compukidmike/DC26/README.md

# DEFCON 26 Projects
This is all the source code and production files for the badges we made for Defcon 26
