compukidmike/DC26/Trevor Totem/Readme.md

# Trevor Totem
The Trevor Totem was a last minute project for Defcon. It holds 7 SAOs and provides power via 2 AA batteries. It also has LEDs to light up the eyes.

If you're unfamiliar with Trevor the Roach, I suggest watching this video: https://www.youtube.com/watch?v=oOXcol_fFGQ

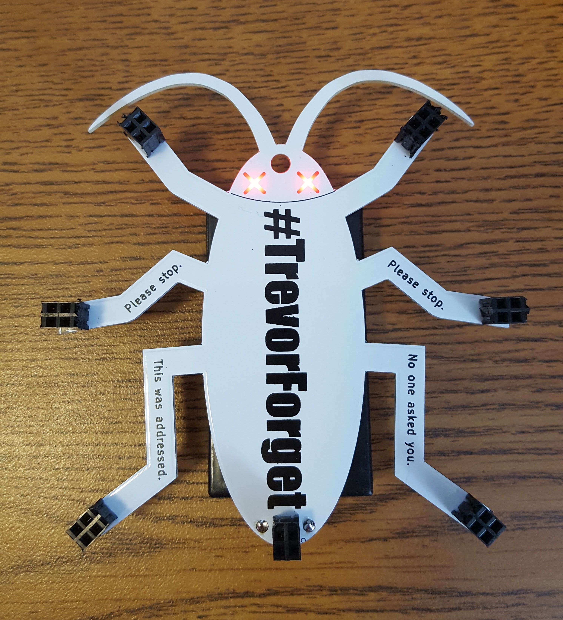
[picture p1: Trevor Totem/TrevorTotem.jpg]
