compukidmike/DC26/GoonBoxBadge/GoonBoxBadge BOM.pdf

Goon Box Badge BOM

Goon Box Pin Part | Qty Reference | Part Number | Vendor Part Number | Link | Alt Link
IR Receiver | 1 U1 | TSOP33438 | TSOP33438-ND | https://www.digikey.com/product-detail/en/vishay-semiconductor-opto-division/TSOP33438/TSOP33438-ND/6210651 https://www.mouser.com/ProductDetail/Vishay-Semiconductors/TSOP33438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 Resistor 0805 240 | 1 R1 | RC0805JR-07240RL | 311-240ARCT-ND | https://www.digikey.com/product-detail/en/yageo/RC0805JR-07240RL/311-240ARCT-ND/731234 Red LED | 1 D1 | 151051RS11000 | 732-5016-ND | https://www.digikey.com/product-detail/en/wurth-electronics-inc/151051RS11000/732-5016-ND/4490012 Battery Holder | 1 BT1 | BAT-HLD-001 | BAT-HLD-001-ND | https://www.digikey.com/product-detail/en/linx-technologies-inc/BAT-HLD-001/BAT-HLD-001-ND/1577235 https://www.mouser.com/ProductDetail/712-BAT-HLD-001 Tie Tack | 1 N/A | N/A | N/A | https://www.amazon.com/Mudder-Butterfly-Clutch-Replacement-Making/dp/B06VXNN1HK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 https://www.amazon.com/Butterfly-Clutch-Replacement-Length-Making/dp/B072B9XGZ4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
PCB 35x50mm | 1 | www.allpcb.com
Screwdriver Part | Qty | Link | Alt Link
IR LED | 1 D1 | SFH 4045N | 475-3047-1-ND | https://www.digikey.com/product-detail/en/osram-opto-semiconductors-inc/SFH-4045N/475-3047-1-ND/4360717
LEDs (red) | 8 D2,D3,D4,D5,D6,D7,D8,D9 | LS T776-P2S1-1-Z | 720-LST776-P2S1-1-Z | https://www.digikey.com/product-detail/en/osram-opto-semiconductors-inc/LS-T776-P2S1-1-Z/475-2517-1-ND/1802644 https://www.mouser.com/ProductDetail/OSRAM-Opto-Semiconductors/LS-T776-P2S1-1-Z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 Resonator 8MHz | 1 Y1 | AWSCR-8.00CV-T | 535-10004-1-ND | https://www.digikey.com/product-detail/en/abracon-llc/AWSCR-8.00CV-T/535-10004-1-ND/2001627 Battery Holder | 1 BT1 | BC12AAPC | BC12AAPC-ND | https://www.digikey.com/product-detail/en/mpd-memory-protection-devices/BC12AAPC/BC12AAPC-ND/2439230
attiny84a | 1 U1 | ATTINY84A-SSUR | ATTINY84A-SSURCT-ND | https://www.digikey.com/product-detail/en/microchip-technology/ATTINY84A-SSUR/ATTINY84A-SSURCT-ND/2774136 Buzzer | 1 BZ1 | PKM13EPYH4000-A0 | 490-4698-ND | https://www.digikey.com/product-detail/en/murata-electronics-north-america/PKM13EPYH4000-A0/490-4698-ND/1219329 Transistor NPN | 1 Q1 | MMBT2222ALT1HTSA1 MMBT2222ALT1HTSA1CT-ND https://www.digikey.com/product-detail/en/on-semiconductor/MMBT2222ALT3G/MMBT2222ALT3GOSCT-ND/1967145 Capacitor 0603 0.1uF | 1 C1 | CL10B104MO8NNNC | 1276-1031-1-ND | https://www.digikey.com/scripts/DkSearch/dksus.dll?Detail&itemSeq=258767980&uq=636600916293556276 Resistor LEDs/Transistor 0603 100 | 9 R6,R8,R9,R10,R11,R12,R13,R14,R15 RMCF0603FG100R | RMCF0603FG100RCT-ND | https://www.digikey.com/product-detail/en/yageo/RC0603JR-07100RL/311-100GRCT-ND/729644 On/Off Switch | 1 SW1 | JS202011JCQN | CKN10723CT-ND | https://www.digikey.com/product-detail/en/c-k/JS202011JCQN/CKN10723CT-ND/6137637 Resistor IR LED 0603 10 | 2 R1,R7 | RMCF0603FG100R | RMCF0603FG100RCT-ND | https://www.digikey.com/product-detail/en/yageo/RC0603JR-07100RL/311-100GRCT-ND/729644 Resistor Touch Buttons 0603 10k | 4 R2,R3,R4,R5 | RC0603JR-0710KL | 311-10KGRCT-ND | https://www.digikey.com/scripts/DkSearch/dksus.dll?Detail&itemSeq=258767456&uq=636600928661943953 PCB 25x150mm | 1 | www.allpcb.com
