compukidmike/DC26/Llama SAO/Llama SAO BOM.xlsx

Llama SAO BOM
Part | Qty | Reference | Part Number | Vendor Part Number | Link | Alt Link
4 pin Header Male | 1 | X1 | 67997-404HLF | 609-3242-ND | https://www.digikey.com/product-detail/en/amphenol-fci/67997-404HLF/609-3242-ND/1878458
Resistor LEDs/Transistor 0603 100 | 1 | R1 | RMCF0603FG100R | RMCF0603FG100RCT-ND | https://www.digikey.com/product-detail/en/yageo/RC0603JR-07100RL/311-100GRCT-ND/729644
LEDs (red) | 2 | D1, D2 | LS T776-P2S1-1-Z | 720-LST776-P2S1-1-Z | https://www.digikey.com/product-detail/en/osram-opto-semiconductors-inc/LS-T776-P2S1-1-Z/475-2517-1-ND/1802644
PCB 90x94mm | 1 |  |  |  | www.allpcb.com
