compukidmike/DC26/Trevor Totem/Trevor Totem BOM.xlsx

Trevor Totem BOM
Part | Qty | Reference | Part Number | Vendor Part Number | Link | Alt Link
4 pin Header Female | 1 | X1, X2, X3, X4, X5, X6, X7 | PPTC022LFBN-RC | S7070-ND | https://www.digikey.com/product-detail/en/sullins-connector-solutions/PPTC022LFBN-RC/S7070-ND/810209
Resistor LEDs/Transistor 0603 100 | 1 | R1 | RMCF0603FG100R | RMCF0603FG100RCT-ND | https://www.digikey.com/product-detail/en/yageo/RC0603JR-07100RL/311-100GRCT-ND/729644
LEDs (red) | 2 | D1, D2 | LS T776-P2S1-1-Z | 720-LST776-P2S1-1-Z | https://www.digikey.com/product-detail/en/osram-opto-semiconductors-inc/LS-T776-P2S1-1-Z/475-2517-1-ND/1802644
Battery Holder | 1 | BT1 | 2463 | 36-2463-ND | https://www.digikey.com/product-detail/en/keystone-electronics/2463/36-2463-ND/303812
PCB 90x94mm | 1 |  |  |  | www.allpcb.com
