compukidmike/DC26/Trevor Totem/KiCad Files/TrevorTotem.kicad_pcb

## KiCad design Trevor Totem/KiCad Files/TrevorTotem.kicad_pcb (2018-08-13)

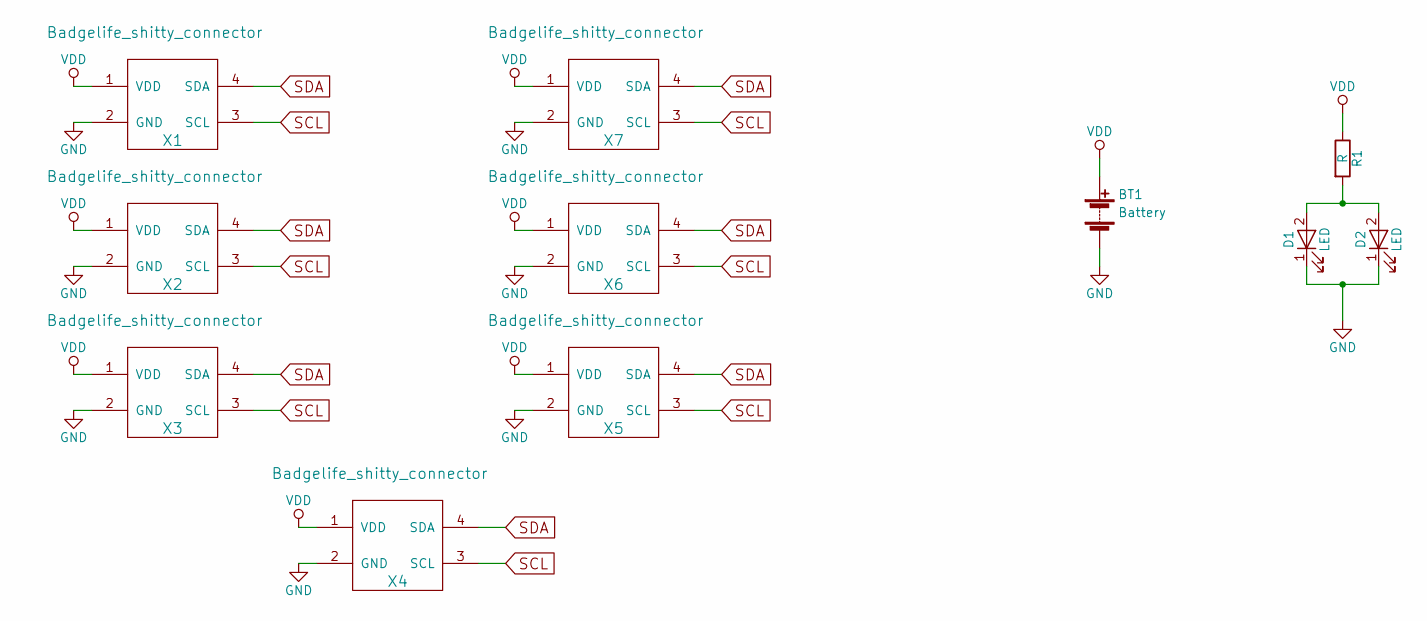
[picture p5: schematic TrevorTotem.sch]

Parts:
BT1: Battery; Battery-WireConn
D1, D2: LED; LED-SMD-BottomEntry-OSRAM-LS-T776
R1: R; R_0603_HandSoldering
X1, X2, X3, X4, X5, X6, X7: Badgelife_shitty_connector; Badgelife-Shitty-2x2

Connections:
GND: BT1.2 (-), D1.1 (K), D2.1 (K), X1.2 (GND), X2.2 (GND), X3.2 (GND), X4.2 (GND), X5.2 (GND), X6.2 (GND), X7.2 (GND)
unnamed: D1.2 (A), D2.2 (A), R1.2
SCL: X1.3 (SCL), X2.3 (SCL), X3.3 (SCL), X4.3 (SCL), X5.3 (SCL), X6.3 (SCL), X7.3 (SCL)
SDA: X1.4 (SDA), X2.4 (SDA), X3.4 (SDA), X4.4 (SDA), X5.4 (SDA), X6.4 (SDA), X7.4 (SDA)
VDD: BT1.1 (+), R1.1, X1.1 (VDD), X2.1 (VDD), X3.1 (VDD), X4.1 (VDD), X5.1 (VDD), X6.1 (VDD), X7.1 (VDD)

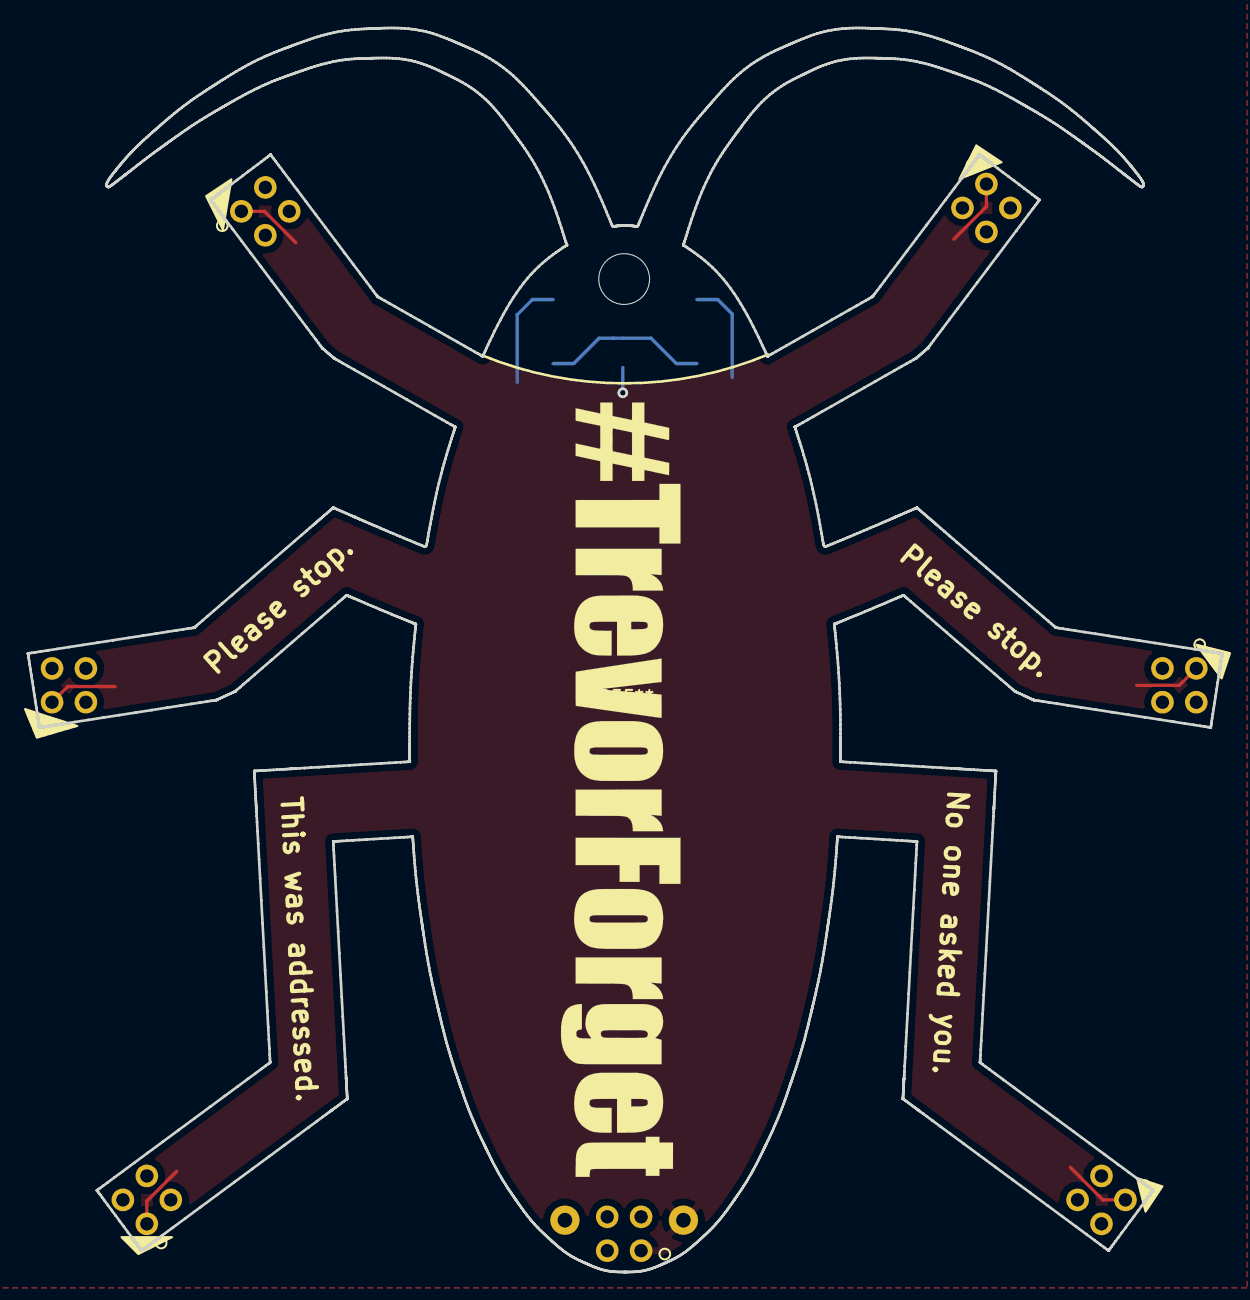
[picture p6: board TrevorTotem.kicad_pcb from above]

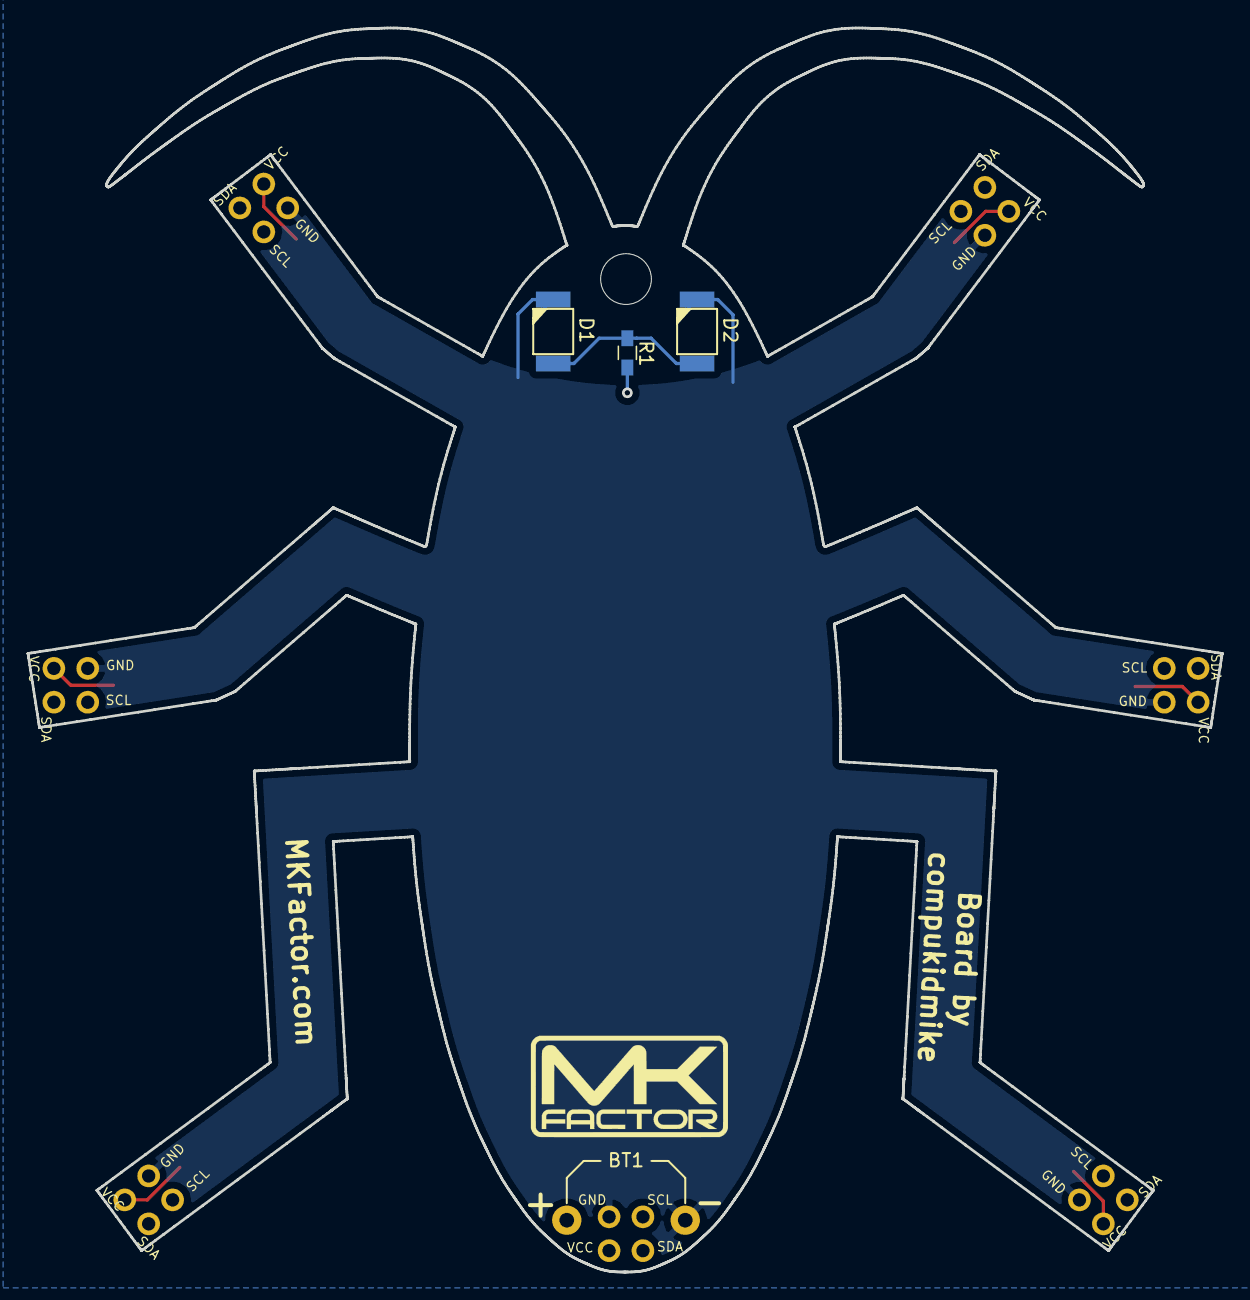
[picture p7: board TrevorTotem.kicad_pcb from below]

Board: 2 copper layers, 89.6 x 93.3 mm, 11 parts (4 on the bottom side), 5 nets.
