compukidmike/DC26/GoonBoxBadge/KiCad Files/Screwdriver/ScrewdriverBadge.kicad_pcb

## KiCad design GoonBoxBadge/KiCad Files/Screwdriver/ScrewdriverBadge.kicad_pcb (2018-08-13)

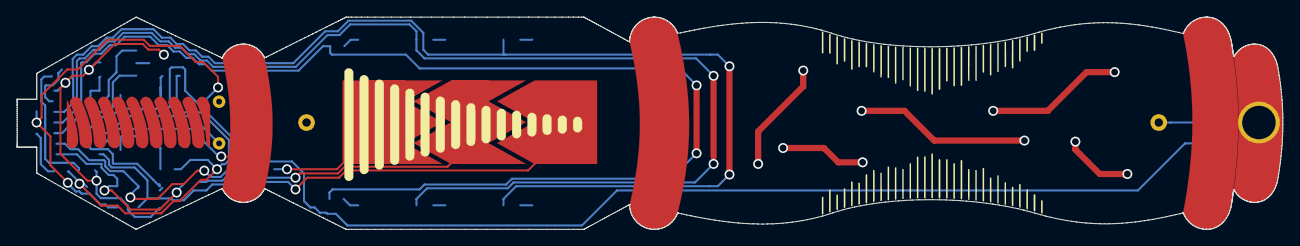
[picture p8: board ScrewdriverBadge.kicad_pcb from above]

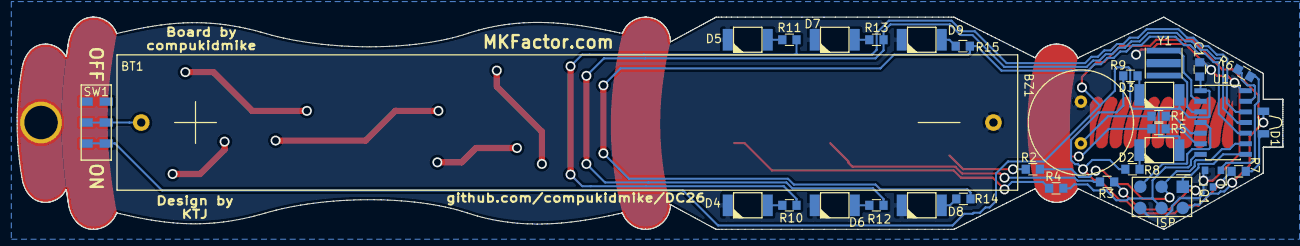
[picture p9: board ScrewdriverBadge.kicad_pcb from below]

Board: 2 copper layers, 151.5 x 25.4 mm, 36 parts (32 on the bottom side), 31 nets.

Parts:
BT1: Battery; Battery-2AA-BC12AAPC
BZ1: Buzzer; Buzzer-12.6mm-Murata-PKM13EPYH4000
C1: 0.1uF; R_0603_Mid
D1: LED; LED-IR-RA-OSRAM-SFH-4045N
D2, D3, D4, D5, D6, D7, D8, D9: LED; LED-SMD-BottomEntry-OSRAM-LS-T776
ISP: AVR-ISP-6; ISP-AVR-6Pin-SMD
Q1: BC817; SOT-23
R1, R2, R3, R4, R5, R6, R7, R8, R9, R10, R11, R12, R13, R14, R15: R; R_0603_Mid
SW1: SW_SPST; JS202011JCQN
TP1: SLIDER1; TestPad-SMD-1mm-Tented
TP2: SLIDER2; TestPad-SMD-1mm-Tented
TP3: SLIDER3; TestPad-SMD-1mm-Tented
TP4: FUNC; TestPad-SMD-1mm-Tented
U1: ATTINY84A-SSU; SOIC-14_3.9x8.7mm_Pitch1.27mm
Y1: Resonator; Resonator-AWSCR-3.7x3.1mm

Connections:
+BATT: C1.1, D1.2, D2.2, D3.2, ISP.2, SW1.1, U1.1
BUZZ: R1.2, U1.5
GND: BT1.2, BZ1.2, C1.2, D4.1, D5.1, D6.1, D7.1, D8.1, D9.1, ISP.6, Q1.2, U1.14, Y1.2
IRLED: R6.2, U1.13
LED1: R10.2, R11.2, U1.12
LED2: R12.2, R13.2, U1.11
LED3: R14.2, R15.2, U1.10
MISO: ISP.1, R3.2, U1.8
MOSI: ISP.4, R4.2, U1.7
unnamed: BT1.1, SW1.2
unnamed: BZ1.1, R1.1
unnamed: D1.1, R7.2
unnamed: D2.1, R8.2
unnamed: D3.1, R9.2
unnamed: D4.2, R10.1
unnamed: D5.2, R11.1
unnamed: D6.2, R12.1
unnamed: D7.2, R13.1
unnamed: D8.2, R14.1
unnamed: D9.2, R15.1
unnamed: Q1.1, R6.1
unnamed: Q1.3, R7.1, R8.1, R9.1
unnamed: R2.1, TP1.1
unnamed: R3.1, TP2.1
unnamed: R4.1, TP3.1
unnamed: R5.1, TP4.1
unnamed: R5.2, U1.6
unnamed: U1.2, Y1.3
unnamed: U1.3, Y1.1
RST: ISP.5, U1.4
SCK: ISP.3, R2.2, U1.9
