compukidmike/DC26/GoonBoxBadge/KiCad Files/GoonBoxPin/GoonBox.kicad_pcb

## KiCad design GoonBoxBadge/KiCad Files/GoonBoxPin/GoonBox.kicad_pcb (2018-08-13)

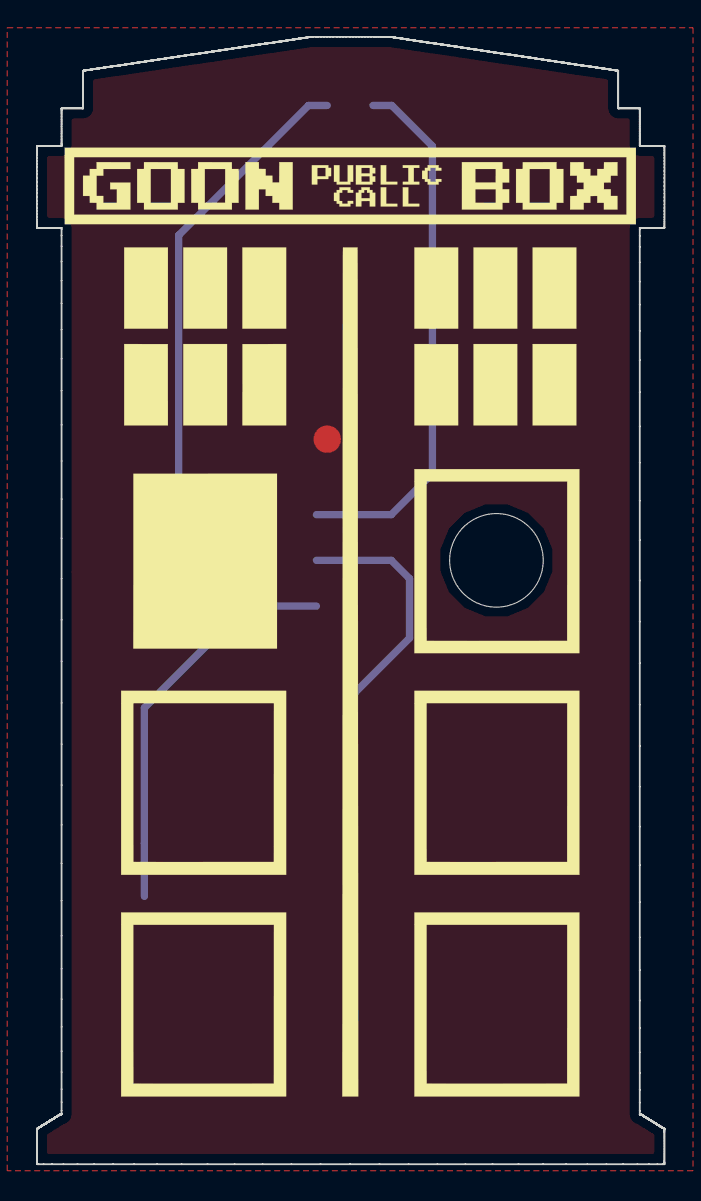
[picture p10: board GoonBox.kicad_pcb from above]

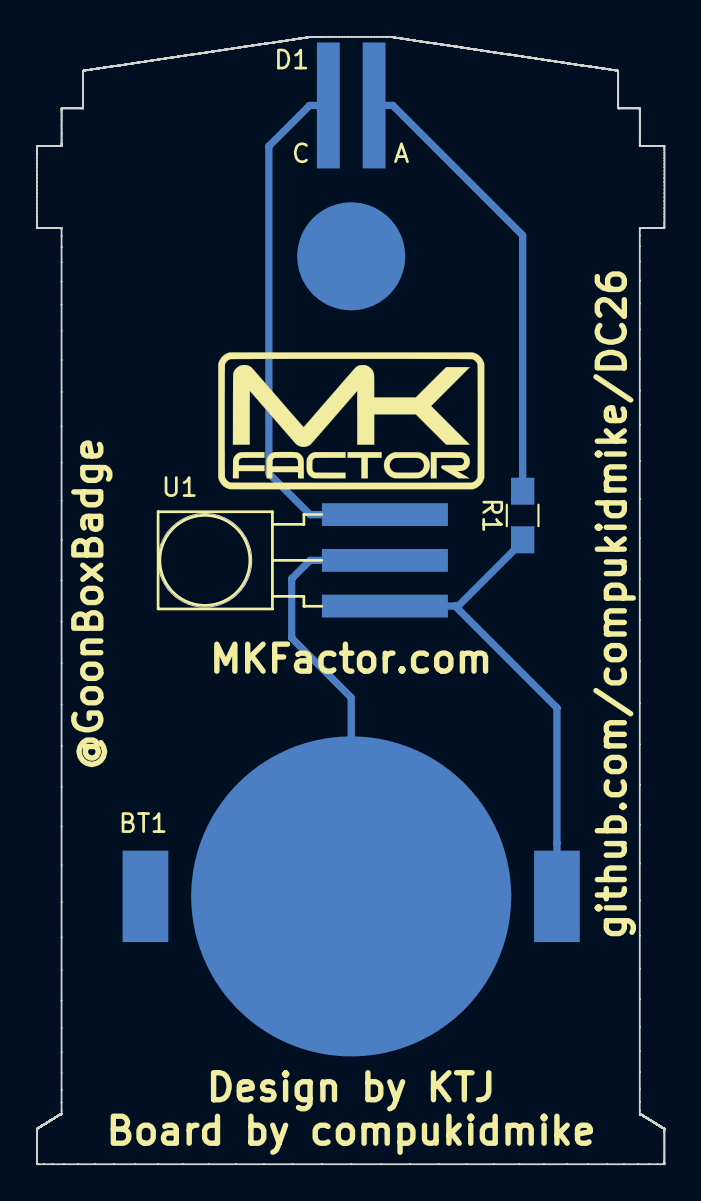
[picture p11: board GoonBox.kicad_pcb from below]

Board: 2 copper layers, 34.9 x 62.6 mm, 4 parts (4 on the bottom side), 4 nets.

Parts:
BT1: Battery_Cell; Linx-BAT-HLD-001
D1: LED; LED-5MM-SMT-FLAT
R1: R; R_0805_HandSoldering
U1: TSOP331xx; TSOP332-IR-RCV

Connections:
+BATT: BT1.1, R1.1, U1.3
GND: BT1.2, U1.2
unnamed: D1.1, U1.1
unnamed: D1.2, R1.2
