compukidmike/DC26/Llama SAO/KiCad Files/LlamaSAO.sch

## KiCad design Llama SAO/KiCad Files/LlamaSAO.sch (2018-08-13)

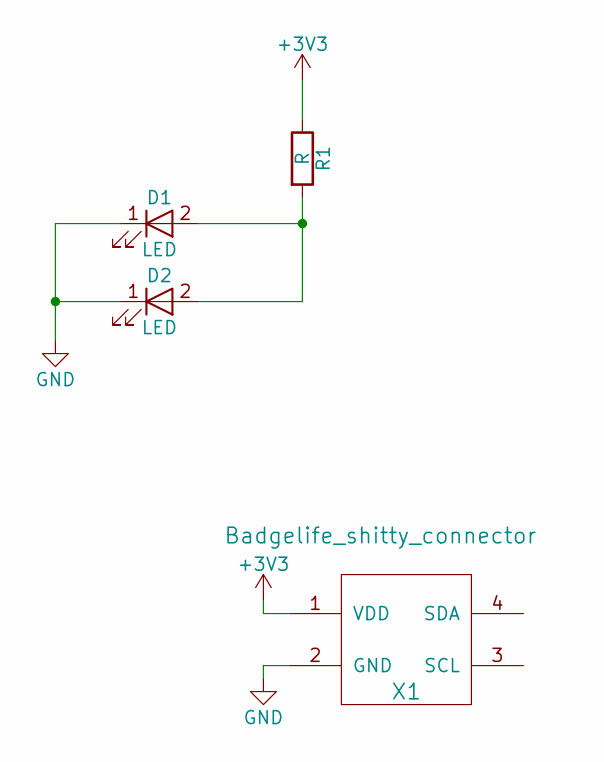
[picture p12: schematic LlamaSAO.sch]

Parts:
D1, D2: LED; LED-SMD-BottomEntry-OSRAM-LS-T776
R1: R; R_0603_Mid
X1: Badgelife_shitty_connector; Badgelife-Shitty-2x2

Connections:
+3V3: R1.1, X1.1 (VDD)
GND: D1.1 (K), D2.1 (K), X1.2 (GND)
unnamed: D1.2 (A), D2.2 (A), R1.2
