compukidmike/DC26/GoonBoxBadge/Code/Screwdriver Badge/screwdriver.h

/**********************************************************************
* Written by WAVToCode
* Date:				Sun Mar 18 05:49:25 PM
* FileName:			screwdriver3.C
* Interleaved:		Yes
* Signed:			No
* No. of channels:	1
* No. of samples:	2721
* Bits/Sample:		8
**********************************************************************/

#define NUM_ELEMENTS 2329

const unsigned char screwdriverSound[NUM_ELEMENTS] PROGMEM = {32, 242, 67, 102, 211, 46, 156, 163, 54, 197, 94, 112, 183, 56, 183, 112, 97, 187, 69, 158, 136, 87, 177, 95, 126, 164, 77, 162, 129, 95, 164, 115, 104, 174, 84, 146, 138, 101, 148, 129, 103, 161, 104, 131, 142, 107, 144, 122, 122, 143, 108, 145, 118, 127, 135, 119, 134, 125, 126, 130, 129, 115, 148, 108, 137, 129, 123, 125, 140, 110, 144, 111, 145, 110, 142, 118, 135, 119, 136, 124, 123, 137, 118, 132, 129, 123, 132, 126, 126, 135, 114, 145, 110, 137, 133, 102, 169, 83, 157, 125, 100, 171, 92, 131, 167, 56, 200, 91, 106, 199, 43, 175, 151, 42, 221, 93, 72, 244, 26, 148, 195, 24, 196, 132, 62, 209, 74, 130, 174, 53, 199, 89, 116, 181, 59, 179, 115, 99, 181, 76, 151, 145, 80, 176, 108, 105, 174, 91, 125, 170, 72, 159, 140, 80, 176, 109, 107, 169, 93, 139, 139, 104, 150, 114, 127, 142, 104, 152, 111, 132, 132, 118, 137, 123, 125, 135, 122, 124, 140, 112, 139, 121, 134, 116, 143, 110, 143, 113, 143, 112, 142, 115, 137, 123, 127, 133, 119, 138, 115, 139, 121, 124, 139, 114, 134, 135, 107, 154, 106, 133, 145, 89, 177, 83, 153, 129, 97, 175, 86, 137, 165, 51, 211, 75, 121, 192, 34, 201, 119, 59, 234, 54, 113, 225, 11, 184, 165, 31, 213, 106, 79, 210, 60, 148, 162, 55, 207, 75, 131, 173, 56, 191, 101, 107, 184, 65, 165, 134, 80, 189, 88, 122, 176, 69, 154, 153, 66, 182, 119, 84, 192, 82, 132, 156, 92, 148, 131, 104, 160, 99, 142, 130, 111, 149, 110, 137, 127, 120, 137, 123, 124, 137, 119, 131, 130, 122, 136, 116, 143, 112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
120, 125, 140, 110, 142, 121, 124, 144, // 280-287
100, 161, 103, 135, 142,  98, 165,  97, // 288-295
140, 139,  95, 164, 106, 122, 156,  92, // 296-303
149, 129, 103, 162, 101, 131, 152,  91, // 304-311
150, 136, 100, 147, 125, 110, 147, 125, // 312-319
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
*/
