compukidmike/DC26/GoonBoxBadge/Code/Screwdriver Badge/NAcodes.c

#include <avr/io.h>             // this contains all the IO port definitions
#include <avr/pgmspace.h>       // definitions or keeping constants in program memory
#include "main.h"

// table of POWER codes
// These codes have been heavily modified to work with the Goon Box Badge Screwdriver!
// You can find the original here: https://learn.adafruit.com/tv-b-gone-kit/

#define freq_to_timerval(x) ((F_CPU / x - 1 )/ 2)

  
// Code 000 -- Sony, Baur, Neckermann, Otto Versand, Palladium, Quelle, SEI, Sinudyne, Sonolor, Universum
const struct powercode sonyCode PROGMEM = {
  //freq_to_timerval(37470), // 37.47 KHz  
  104,
  {{184, 45},
   {92 , 45},
   {46 , 45},
   {92, 45},
   {46 , 45},
   {92, 45},
   {46 , 45},
   {46 , 45},
   {92, 45},
   {46 , 45},
   {46 , 45},
   {46 , 45},
   {46 , 2068},
   {184, 45},
   {92, 45},
   {46 , 45},
   {92, 45},
   {46 , 45},
   {92, 45},
   {46 , 45},
   {46 , 45},
   {92, 45},
   {46 , 45},
   {46 , 45},
   {46 , 45},
   {46 , 0}// end of code
  }
};

//Code 001 - Proscan, RCA, Curtis Mathes, Dimensia, GE, JC Penney, LXI, Radio Shack/Realistic, Sears, Wards
const struct powercode rcaCode PROGMEM = {
  //freq_to_timerval(55600), // 55.6 KHz  
  70,
  {{ 457,   456 },
   {  58,   228 },
   {  58,   228 },
   {  58,   228 },
   {  58,   228 },
   {  58,   113 },
   {  58,   113 },
   {  58,   228 },
   {  58,   113 },
   {  58,   228 },
   {  58,   113 },
   {  58,   228 },
   {  58,   113 },
   {  58,   113 },
   {  58,   113 },
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
    { 59,	   57},
    { 59,	   57},
    { 59,	   57},
    { 58,	  178},
    { 59,	  178},
    { 59,	  178},
    { 59,	   57},
    { 59,	   57},
    { 59,	  178},
    { 59,	  178},
    { 59,	  178},
    { 59,	 4260},
    {924,	  231},
    { 59,	 9752},
    {924,	  231},
    { 59,	    0}
  }
};

// Code 054 - JVC
const struct powercode jvc3Code PROGMEM = {
  freq_to_timerval(38970),
  { {924,	  459},
    { 59,	  178},
    { 59,	  178},
    { 59,	  178},
    { 59,	   57},
    { 59,	  178},
    { 59,	  178},
    { 59,	   57},
    { 59,	   57},
    { 59,	   57},
    { 59,	   57},
    { 59,	   57},
    { 59,	  178},
    { 59,	   57},
    { 59,	   57},
    { 59,	  178},
    { 59,	  178},
    { 59,	   57},
    { 59,	  178},
    { 59,	   57},
    { 59,	   57},
    { 59,	  178},
    { 59,	   57},
    { 59,	   57},
    { 59,	   57},
    { 59,	  178},
    { 59,	   57},
    { 59,	  178},
    { 59,	  178},
    { 59,	   57},
    { 59,	  178},
    { 59,	  178},
    { 58,	  178},
    { 59,	 4260},
    {924,	  231},
    { 59,	 9752},
    {924,	  231},
    { 59,	    0}
  }
};

// Code 055 - Kloss Novabeam, Magnavox, Philco, Philips, Sylvania, Wards
const struct powercode klossCode PROGMEM = {
  freq_to_timerval(54070),
  { { 53,	  237},
    { 53,	  812},
    { 53,	  237},
    { 53,	  812},
    { 53,	  237},
    { 53,	  812},
    { 53,	  237},
    { 53,	  524},
    { 53,	  524},
    { 53,	  237},
    { 53,	  237},
    { 53,	  237},
    { 53,	  237},
    { 53,	  524},
    { 53,	 2959},
    { 53,	  237},
    { 53,	  812},
    { 53,	  237},
    { 53,	  812},
    { 53,	  237},
    { 53,	  812},
    { 53,	  237},
    { 53,	  524},
    { 53,	  524},
    { 53,	  237},
    { 53,	  237},
    { 53,	  237},
    { 53,	  237},
    { 53,	  524},
    { 53,	    0}
  }
};
*/


/*const PGM_P * const powerCodes[] PROGMEM  = {
  &sonyCode, &rcaCode, &panasonicCode, &sharpCode, &toshibaCode,
  &philipsCode, &samsungCode,&zenithCode, &pioneerCode, &sylvaniaCode,
  &jvcCode, &hitachiCode, &sampoCode, &hisenseCode, &viewsonicCode,
  &bushCode, &aocCode, &bellCode, &pioneer2Code, &fujitsuCode,
  &goldstarCode, &daewooCode, &NECCode, &admiralCode, &sony2Code,
  &viewsonic2Code, &zenith2Code, &thompsonCode, &brillianCode, &magnavoxCode,
  &viewsonic3Code, &crownCode, &hitachi2Code, &fujitsu2Code, &hitachi3Code,
  &NEC2Code, &hitachi4Code, &anamCode, &aoc2Code, &candleCode,
  &contecCode, &contec2Code, &sony3Code, &alleronCode, &contec3Code, 
  &fisherCode
};*/

//These are the codes that fit in available program space
const PGM_P * const powerCodes[] PROGMEM  = {
	&sonyCode, &rcaCode, &panasonicCode, &sharpCode, &toshibaCode,
	&philipsCode, &samsungCode, &zenithCode, &pioneerCode, &sylvaniaCode,
	&jvcCode, &hitachiCode, &sampoCode, &hisenseCode, &viewsonicCode,
	&bushCode, &aocCode, &bellCode, &pioneer2Code, &fujitsuCode,
	&goldstarCode, &daewooCode, &NECCode, &admiralCode
};


uint8_t num_codes = (sizeof(powerCodes)/sizeof(*powerCodes));
