compukidmike/DC26/(commit log)

2018-08-13 Add GoonBoxBadge Files
    [GoonBox.kicad_pcb, GoonBox.sch, GoonBoxBadge BOM.xlsx, ScrewdriverBadge.kicad_pcb, ScrewdriverBadge.sch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]
2018-08-13 Add Llama SAO and Trevor Totem files
    [Llama SAO BOM.xlsx, LlamaSAO.sch, Trevor Totem BOM.xlsx, TrevorTotem.kicad_pcb, TrevorTotem.sch]
